Diginomicon/LR3Micro/LR3Micro Wiring.png

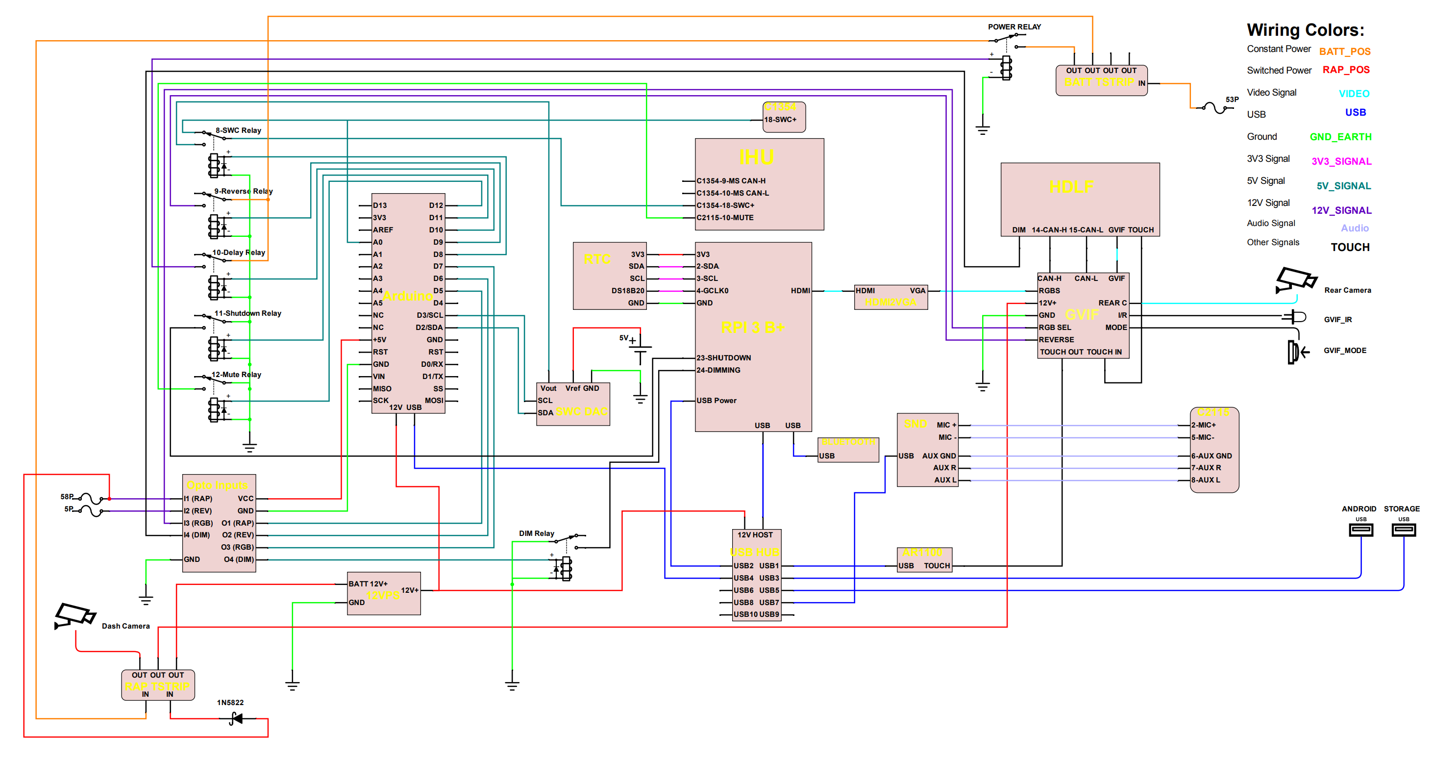
LR3Micro Wiring.png
