Diginomicon/LR3Micro/(commit log)

2020-12-07 Initial version of Arduino Code for LR3 signal controller
2020-12-07 Switch SWC trigger values to IHU direct measurements instead of A0 voltage divider Increase SWC tolerance to work with IHU and 3.3k resistor Clarified comments in some of the functions Removed debug 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
    [LR3Micro.ino]
2020-12-07 Wiring Schematic of OpenAuto Pro installed in LR3 using LR3Micro
